Jokersherlock/Frodo/doc/指令设计.md

# 指令设计

## shake指令

1. **absorb**

0（1位）+2位func+addr（12位）+round（10位）+安全等级（1位）

2. **absorbload**

0（1位）+2位func+addr（12位）+round（10位）+ 安全等级（1位）+ 是否吸收（1位）

3. **squeeze**

0 (1位) + 2位func + round（10位）+ 安全等级

4. **squeezestore**

0(1位) + 2位func + round(10位) + 安全等级 + 是否挤压

## MAC指令

1(1位) + 2位 + 4位 + 4位 + 4位 

S存储: 每次一个数,地址+1(假设64位一个地址),加到这列结束,地址归0,记录标志位+1,此后每一次都是读出来,填进去,写回去.

S'存储: 每次一个8bit数,凑满64位存储(使用一个寄存器和标志位),地址加一

E,E'' 每次一个16bit的数
