Jokersherlock/Frodo/doc/FrodoKEM流程v4.pdf

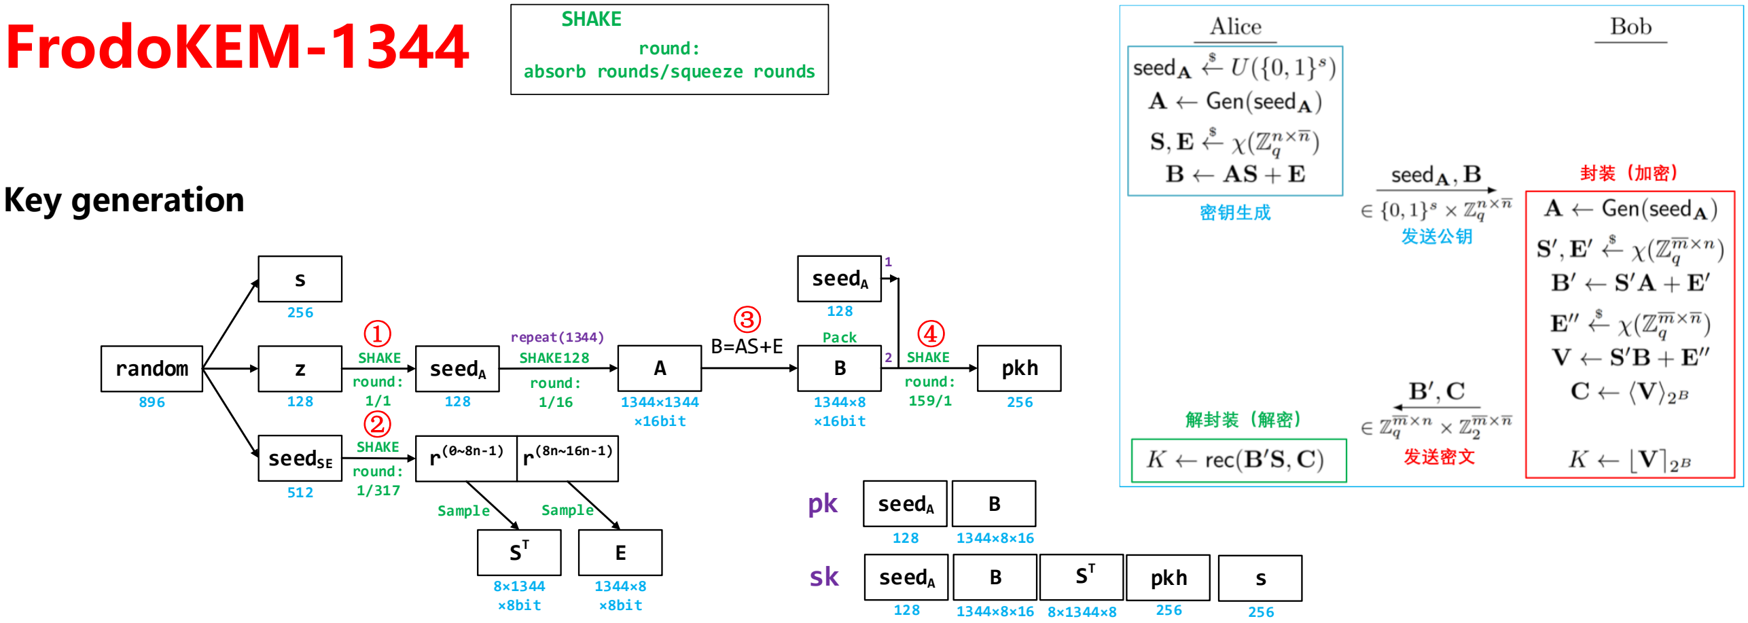
[picture p45: figure]
Key generation; random; seedSE; seedA; FrodoKEM-1344; SHAKE round: 1/1; SHAKE; round: absorb rounds/squeeze rounds; SHAKE128; round: 1/16; repeat(1344); round: 1/317; round: 159/1; pkh; B pkh; Sample; 8×1344 ×8bit; 1344×8 ×8bit; 1344×1344 ×16bit; 1344×8 ×16bit; Pack

# Encapsulation

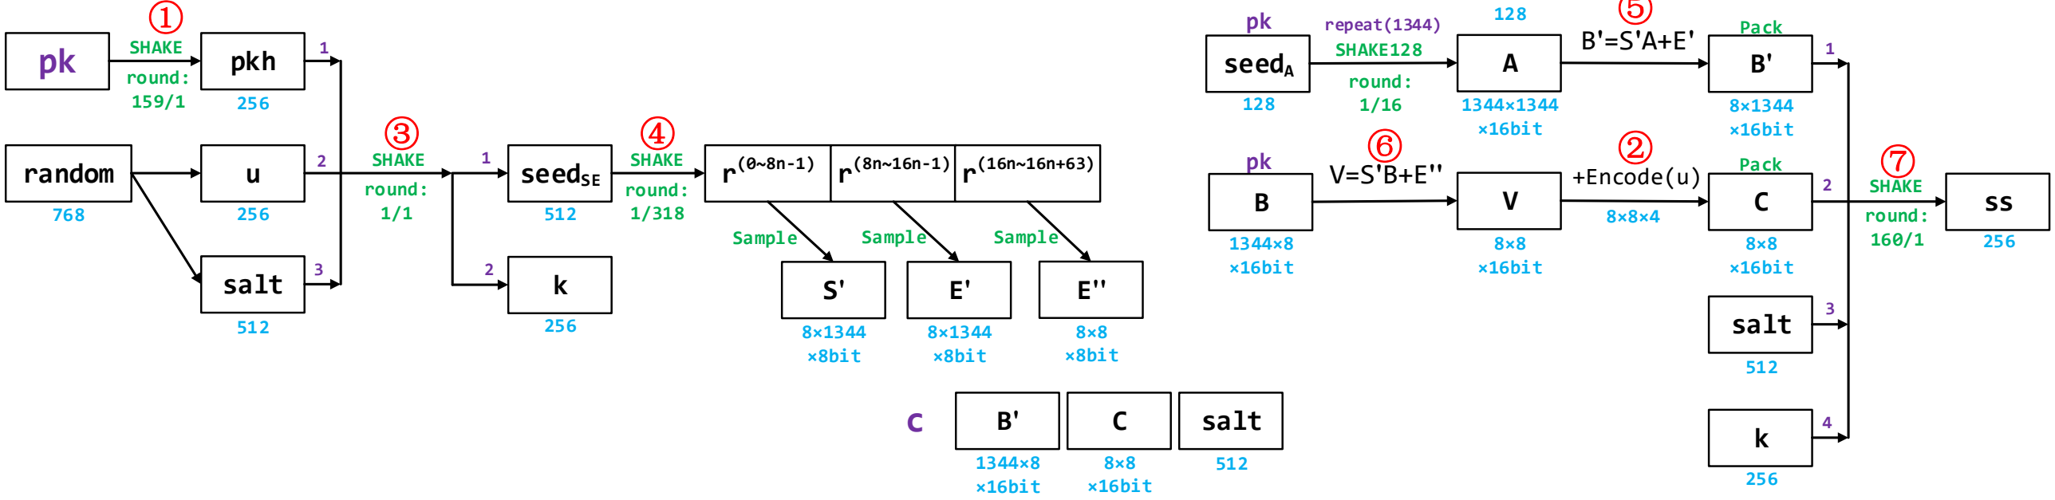
[picture p46: figure]
random; salt; SHAKE round: 1/1; pkh; SHAKE; round: 159/1; seedSE; Sample; 8×1344 ×8bit; round: 1/318; 8×8 ×8bit; seedA; SHAKE128; round: 1/16; repeat(1344); 1344×1344 ×16bit; 8×1344 ×16bit; 1344×8 ×16bit; 8×8 ×16bit; +Encode(u); SHAKE round:; Pack
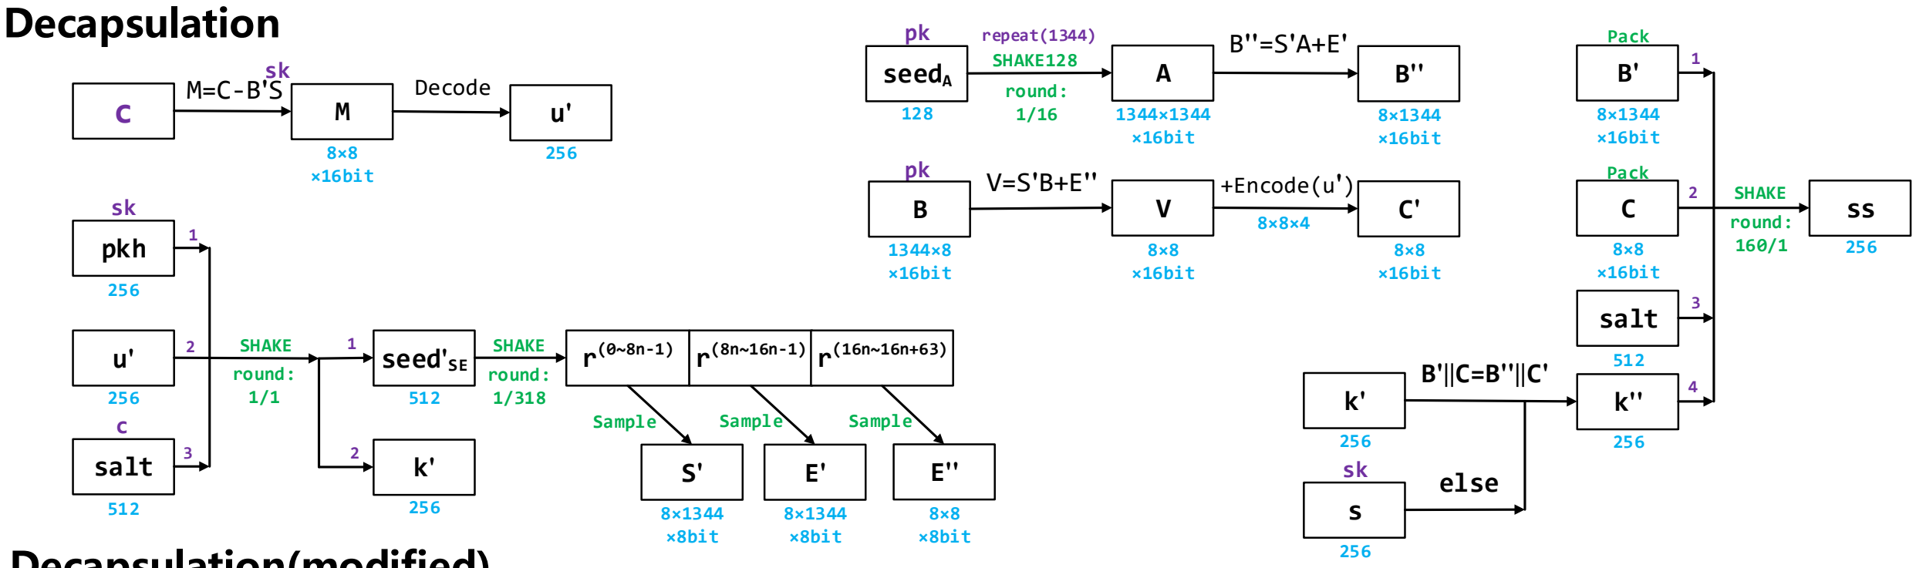
[picture p47: figure]
Decapsulation; salt; SHAKE round: 1/1; pkh; seed'SE; Sample; 8×1344 ×8bit; SHAKE; round: 1/318; 8×8 ×8bit; seedA; SHAKE128; round: 1/16; repeat(1344); 1344×1344 ×16bit; 8×1344 ×16bit; 1344×8 ×16bit; 8×8 ×16bit; +Encode(u'); SHAKE round:; Decode; else; Pack
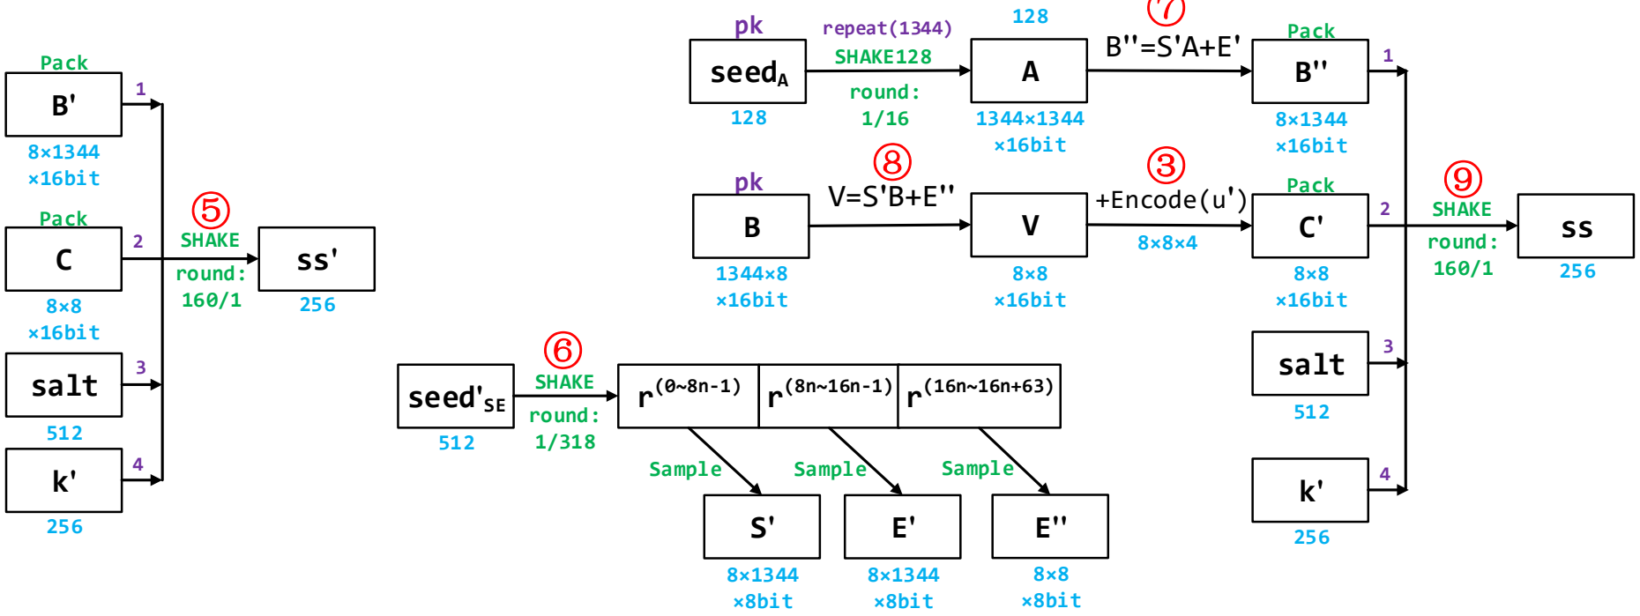
[picture p48: figure]
salt; SHAKE round:; 8×1344 ×16bit; 8×8 ×16bit; Pack; seed'SE; Sample; 8×1344 ×8bit; SHAKE; round: 1/318; 8×8 ×8bit; seedA; SHAKE128; round: 1/16; repeat(1344); 1344×1344 ×16bit; 1344×8 ×16bit; +Encode(u'); round:

u'

## salt

512

256

SHAKE
round:
1/1

## pkh

256

## seed'SE

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
## M=C-B'S

M

8×8
×16bit

### Decode

u'

256

sk

c

# Decapsulation(modified)

4

A

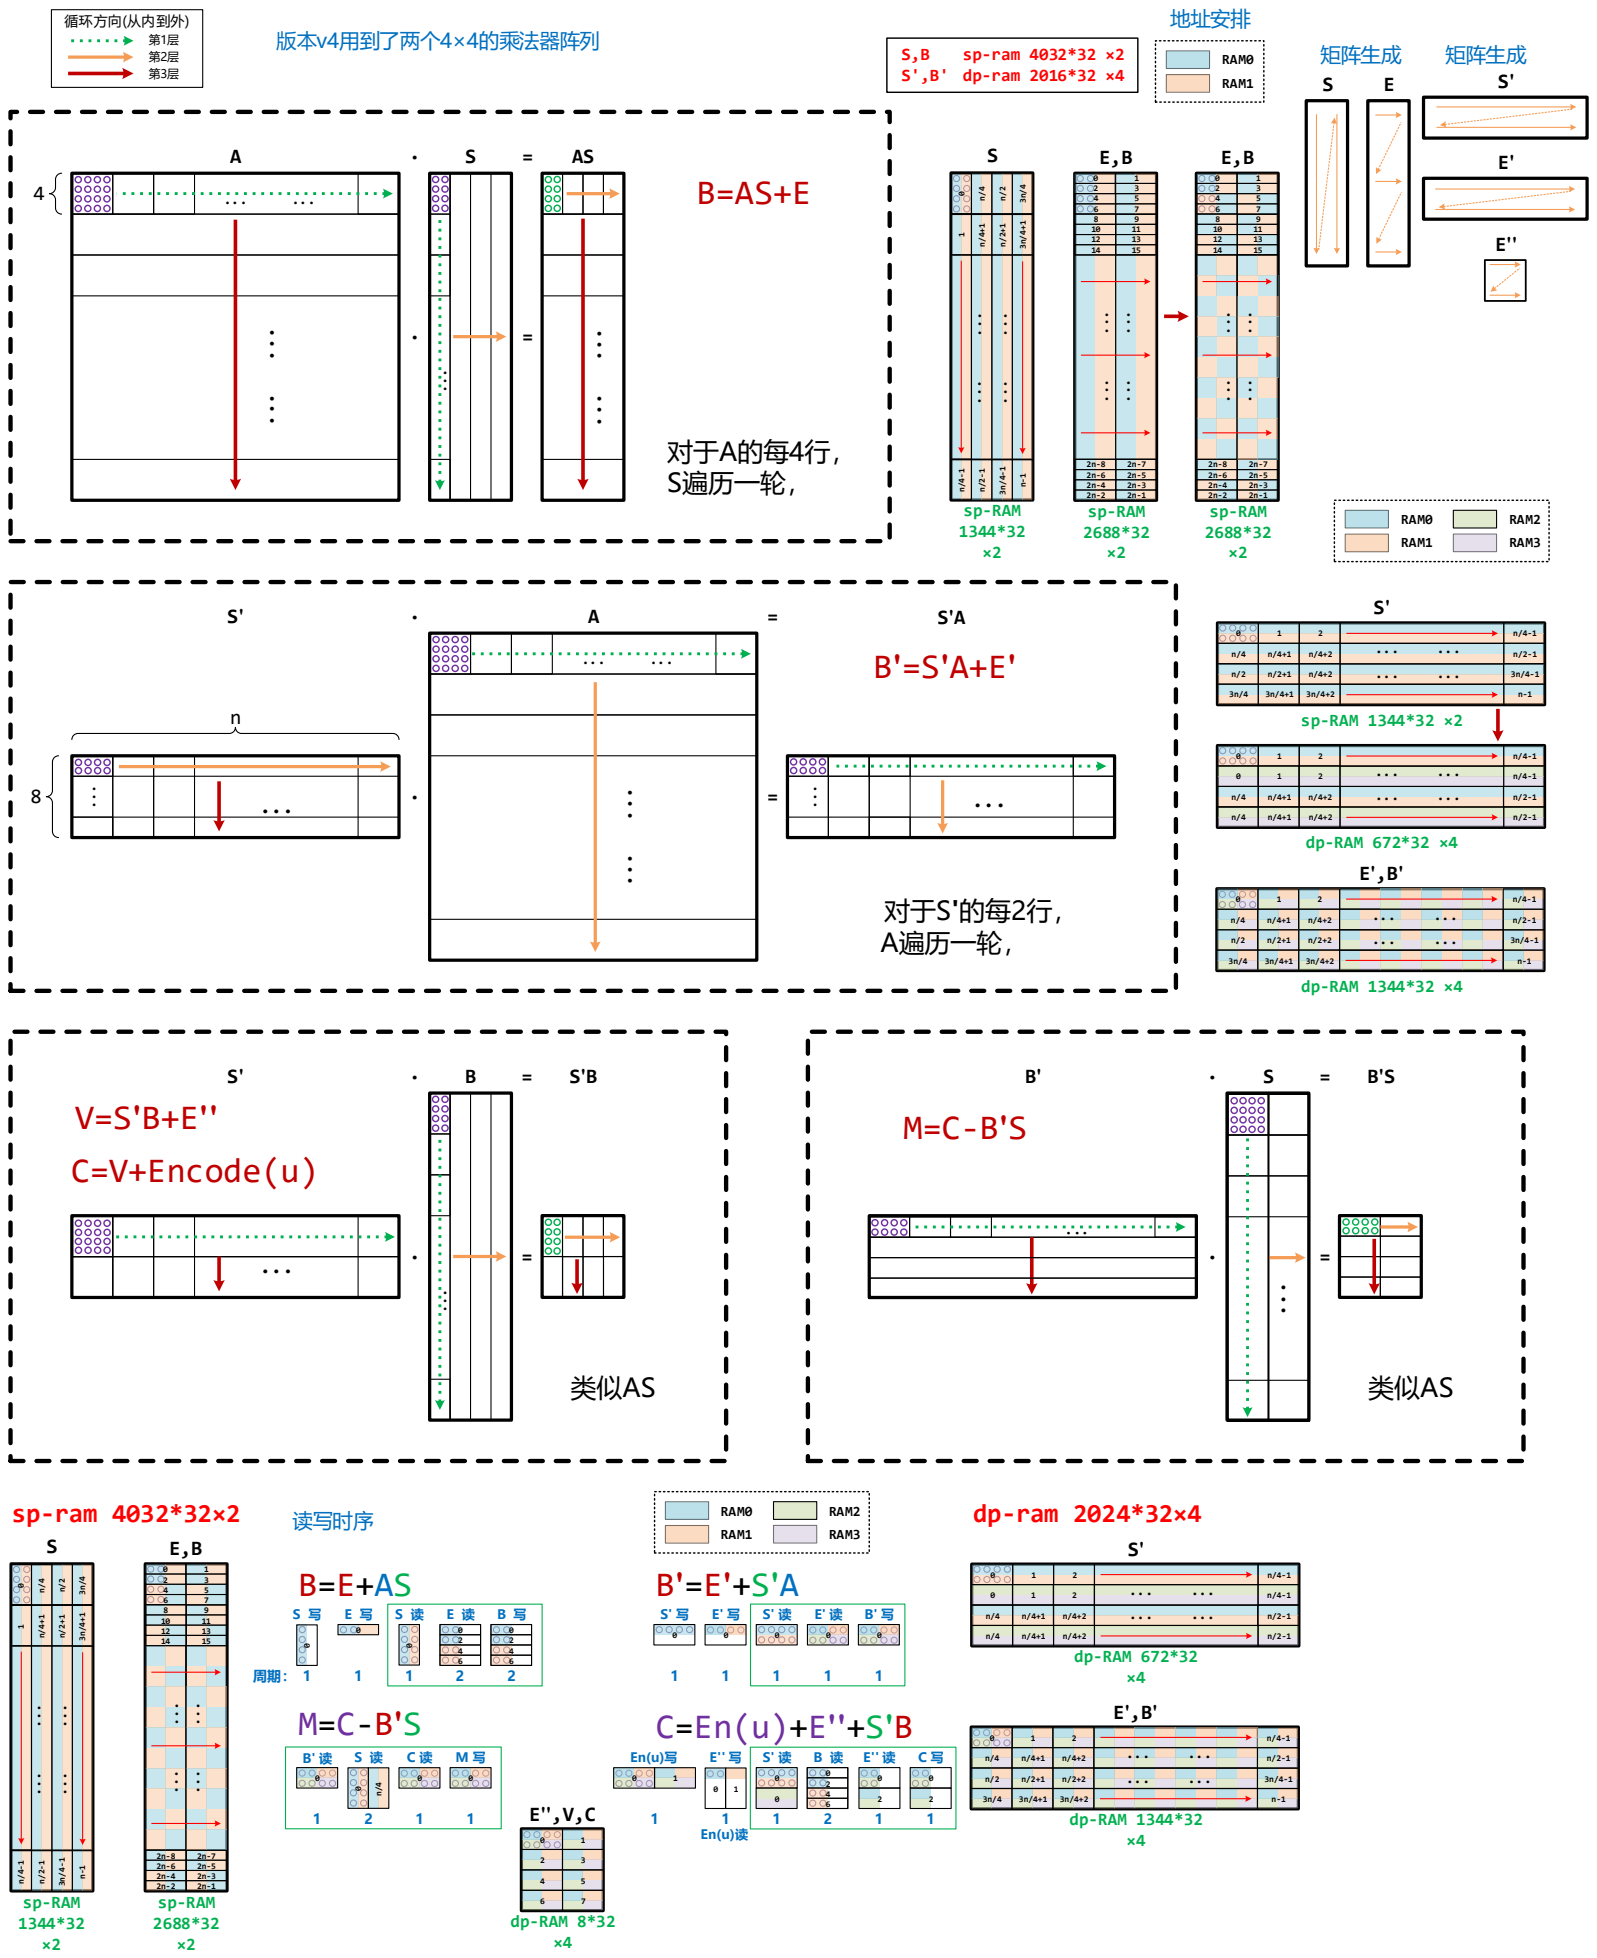
[picture p49: page 2]
循环方向(从内到外); 对于A的每4行， S遍历一轮，; 地址安排; 类似AS; 版本v4用到了两个4×4的乘法器阵列; 矩阵生成; sp-RAM 1344*32 ×2; dp-RAM 1344*32 ×4; dp-RAM 672*32 ×4; RAM0; RAM1; RAM2; RAM3; C=V+Encode(u); sp-RAM 2688*32 ×2; 对于S'的每2行， A遍历一轮，; sp-ram 4032*32 ×2; S',B' dp-ram 2016*32 ×4; sp-ram 4032*32×2; 读写时序; dp-ram 2024*32×4; dp-RAM 8*32 ×4

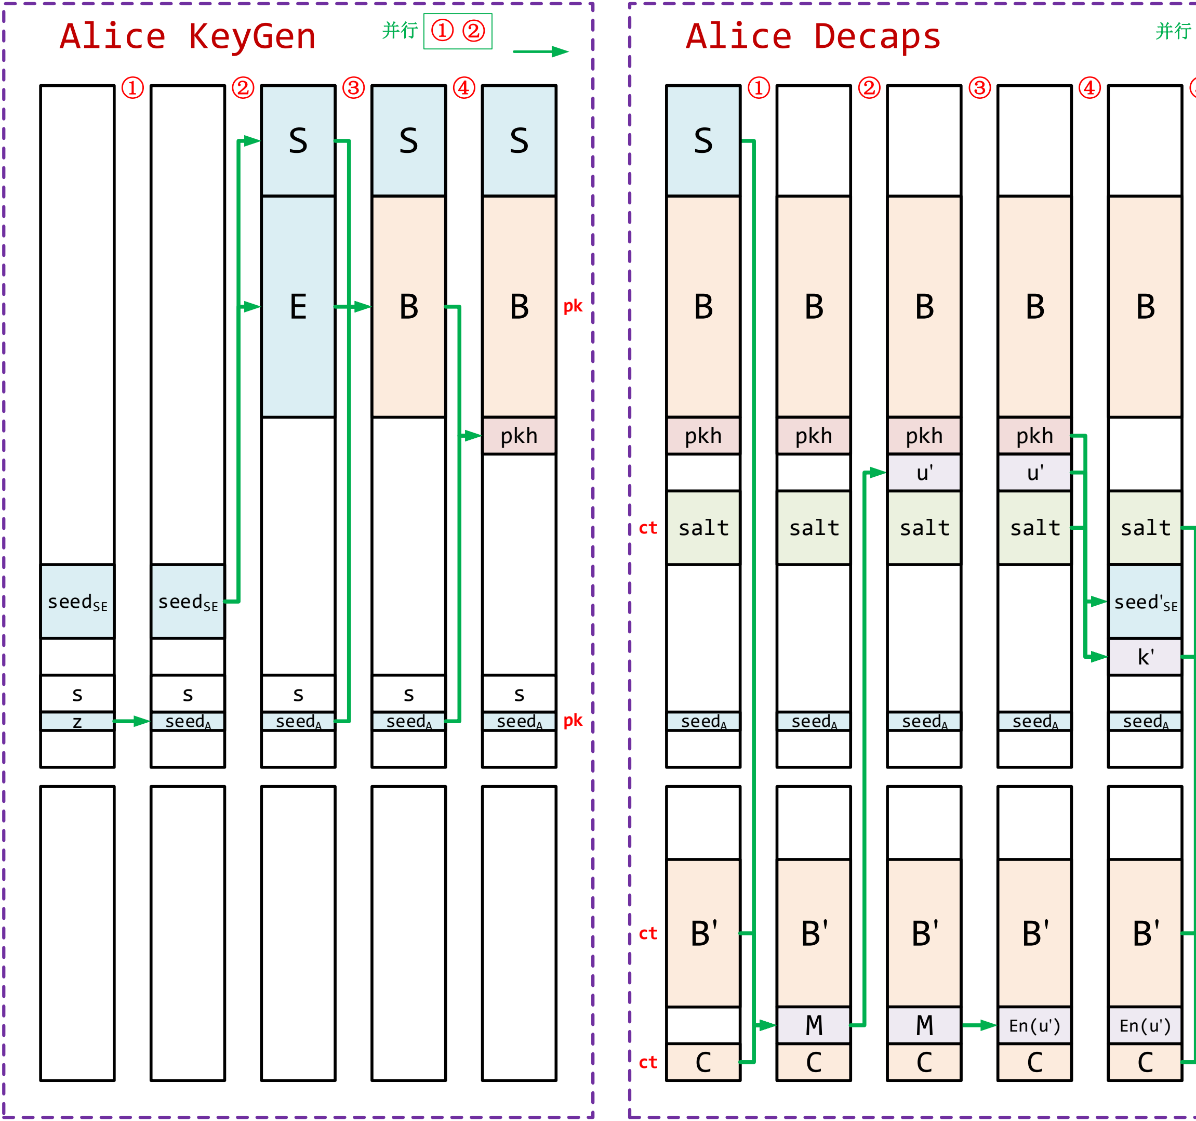
[picture p50: figure]
seedSE; seedA; pkh; Alice KeyGen; Alice Decaps
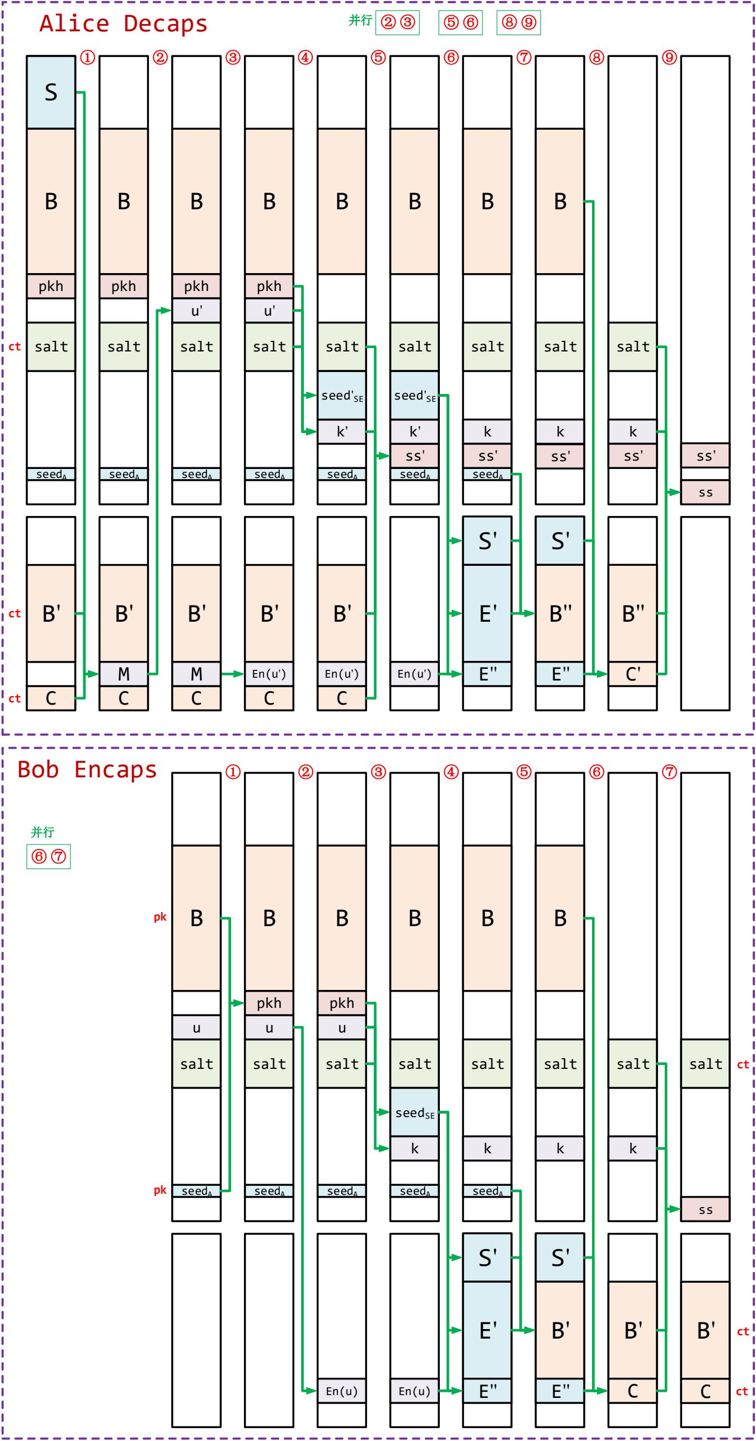
[picture p51: figure]
salt; seedA; pkh; seedSE; seed'SE; Bob Encaps

1344
S

## sp-RAM 32bit

×2

## dp-RAM 32bit

×4

S' 2688

E

E'

s
z

## seedSE

2

4

8

4

# pkh

4

u

4

k

8

# salt

672 1344

8

E''

8

C

4

ss

## depth:

4070

## depth:

2032

## frodo

640

## frodo

976

## frodo

1344

128 | 128 | 128
128 | 192 | 256
128 | 192 | 256
128 | 192 | 256
128 | 192 | 256
256 | 384 | 512
256 | 384 | 512
128 | 192 | 256

0

1344

4032

4036

4040

4048

4056

4060

4064
4066

4070

0

672

2016

2024

2032

### >>> bin(2016)

'0b11111100000'

### >>> bin(4032)

'0b111111000000'

addr | addr

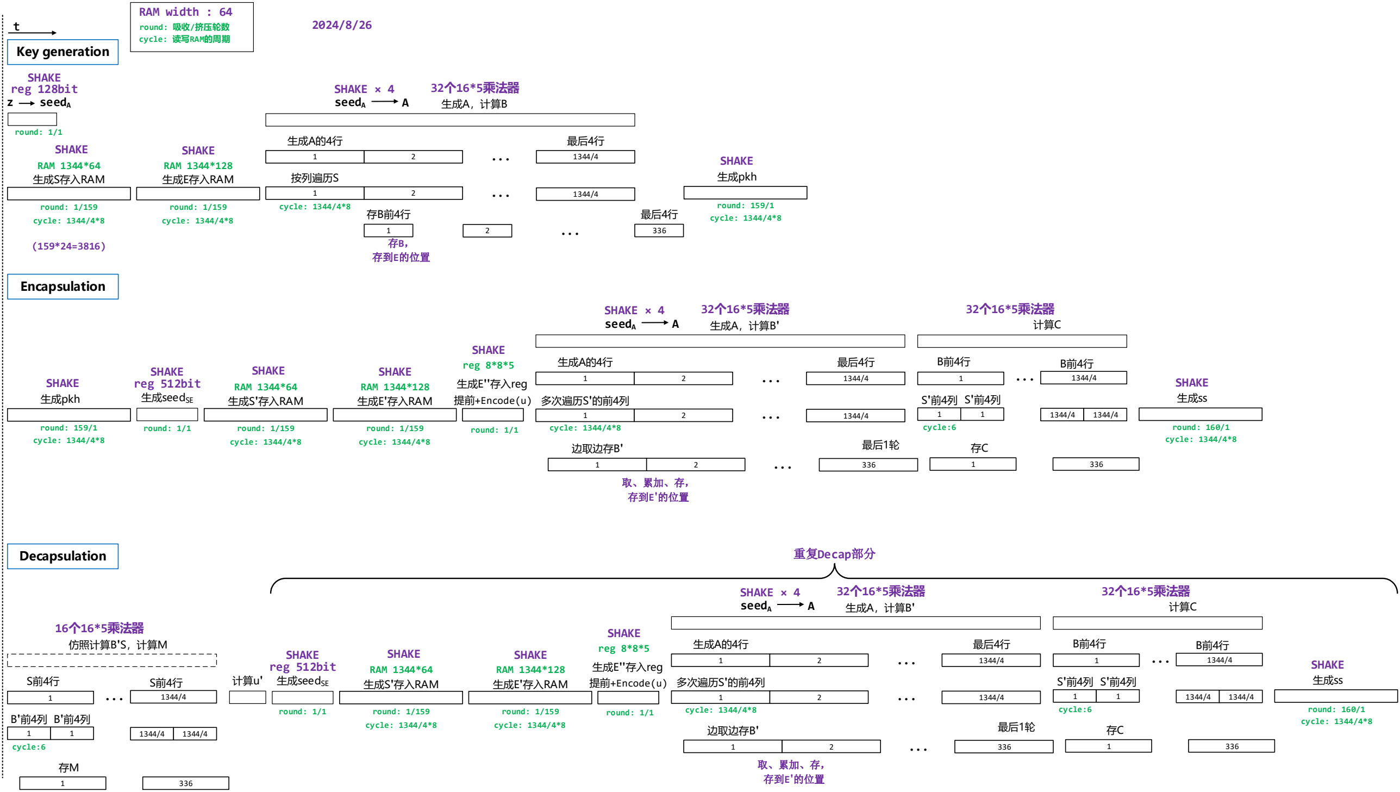
[picture p52: figure]
seedA; SHAKE × 4; 生成A的4行; 按列遍历S; reg 128bit; 生成S存入RAM; RAM 1344*64; 生成E存入RAM; RAM 1344*128; round: 1/1; round: 1/159; cycle: 1344/4*8; 生成A，计算B; Key generation; 32个16*5乘法器; 存B， 存到E的位置; 存B前4行; 生成pkh; SHAKE; RAM width : 64; Encapsulation; Decapsulation; reg 512bit; 多次遍历S'的前4列; 生成A，计算B'; 取、累加、存， 存到E'的位置; 边取边存B'; 生成S'存入RAM; RAM 1344*128 生成E'存入RAM; 生成E''存入reg; reg 8*8*5; round: 吸收/挤压轮数 cycle: 读写RAM的周期; 生成seedSE; round: 159/1; 计算C; 提前+Encode(u); cycle:6; 生成ss; round: 160/1; 仿照计算B'S，计算M; 16个16*5乘法器; 计算u'; 重复Decap部分
