Jokersherlock/Frodo/doc/temp.png

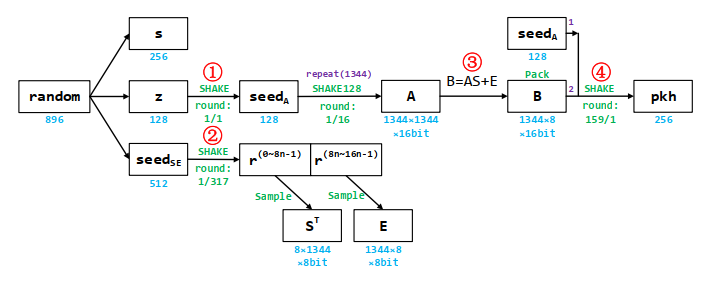
doc/temp.png
