Jokersherlock/Frodo/rtl/SHA3all/design/default_parms.v

`define PARMS                                                         /*                                                                 */   
`define SHA3_B             1600                                       /*  bit width of Keccak-p permuation                               */  
`define SHA3_W             64                                         /*  (64) lane size of Keccak-p permuation in bits                  */  
`define SHA3_NROUNDS       24                                         /*  Max rounds Keccak-p permutation 1600 = 12+2*SHA3_L =12+2*6 =24 */  
`define SHA3_D             256                                        /*  digest length for sha3                                         */  
`define SHA3_BITLEN        11                                         /*  Bit length {0..1088}                                           */  
`define SHA3_L             25                                         /*  Number of lanes of W-bits                                      */  
